9qUmV4/nwt-ballwippe/README.md

# Projekt Ballwippe

Dies ist ein Schulprojekt.

## Inhaltsverzeichnis
- [Projektauftrag](docs/Konstruktionsauftrag%20Ballwippe.pdf)
- [Dokumentation](docs/Projektdokumentation.md)
- [Notizen](docs/Notes.pdf)
- [CAD-Dateien](cad-files):
  - [Endplatte](cad-files/Endplatte.FCStd)
  - [Fuß](cad-files/Fuss.FCStd)
  - [Lager](cad-files/Lager.FCStd)
  - [Gesamtmodell](cad-files/Wippe_gesamt.FCStd)
