9qUmV4/nwt-ballwippe/cad-files/Grundplatte.FCStd

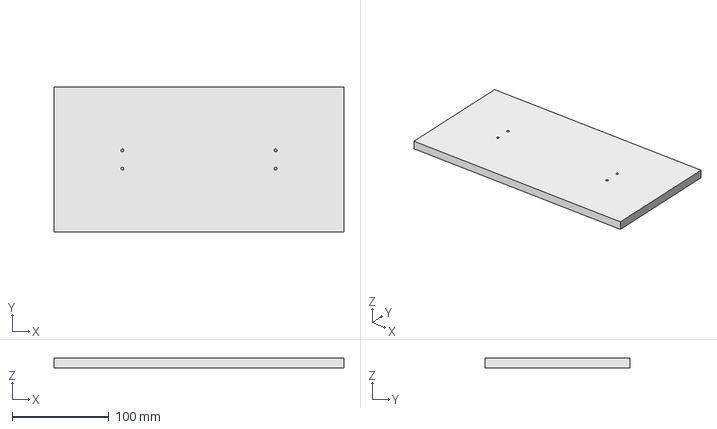
[picture p2: CAD file, 2022-02-23]
cad-files/Grundplatte.FCStd
300.0 x 150.0 x 10.0 mm
