9qUmV4/nwt-ballwippe/cad-files/stl-files/Fuss-Body.stl

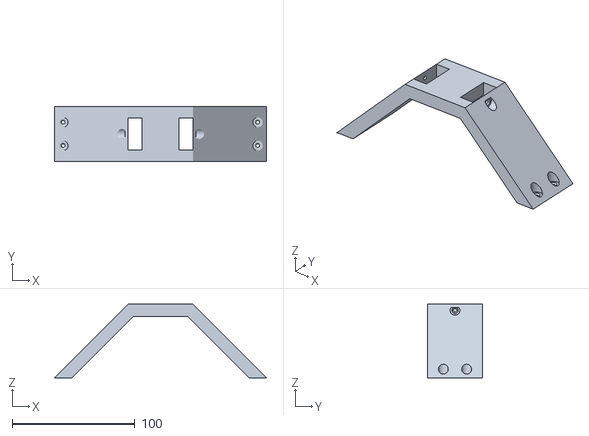
[picture p3: CAD file, 2022-04-05]
cad-files/stl-files/Fuss-Body.stl
172.8 x 45.0 x 60.0
