9qUmV4/nwt-ballwippe/cad-files/Achse.FCStd

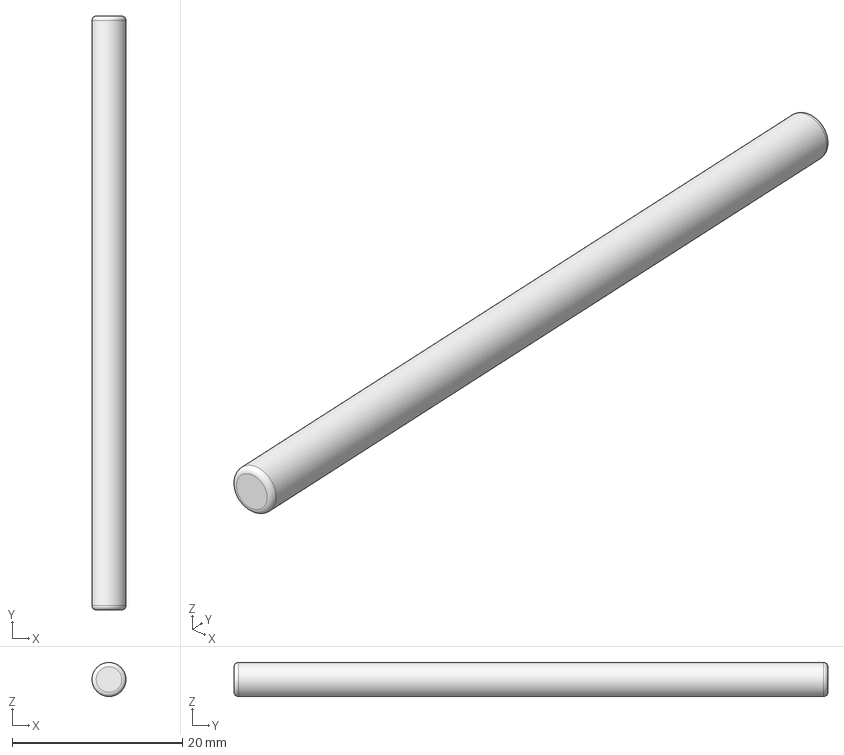
[picture p4: CAD file, 2022-02-23]
cad-files/Achse.FCStd
4.00 x 69.8 x 4.00 mm
