9qUmV4/nwt-ballwippe/cad-files/stl-files/Lager-Body.stl

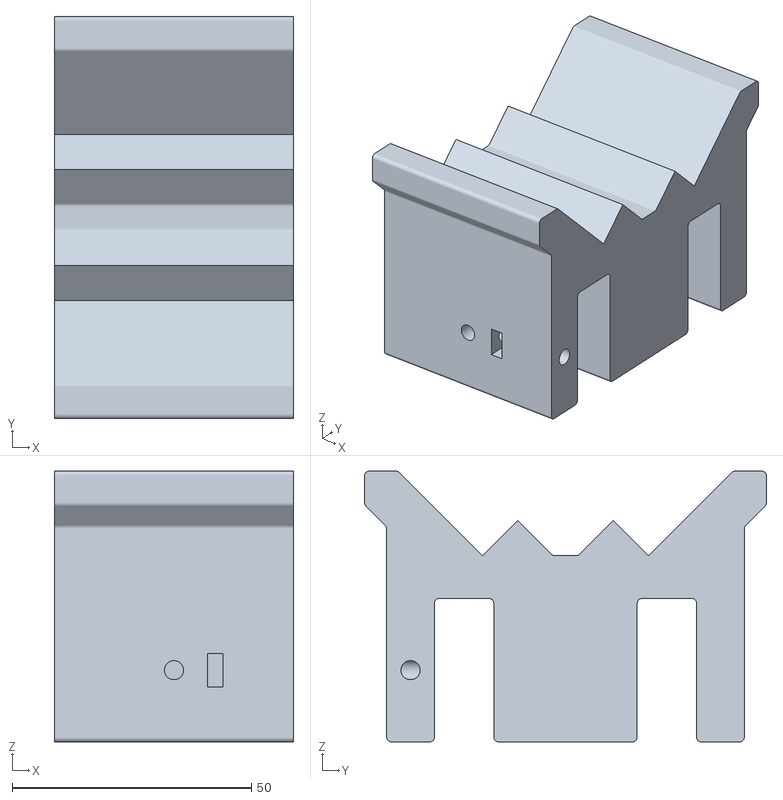
[picture p5: CAD file, 2022-04-05]
cad-files/stl-files/Lager-Body.stl
50.0 x 84.1 x 56.6
