9qUmV4/nwt-ballwippe/cad-files/stl-files/Endplatte-Body.stl

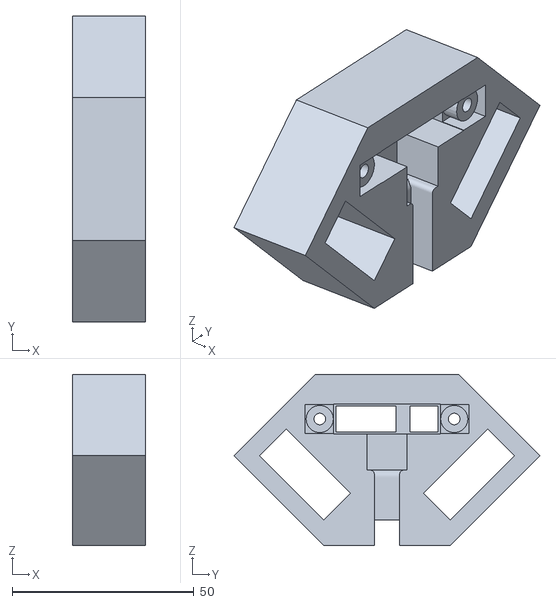
[picture p6: CAD file, 2022-04-05]
cad-files/stl-files/Endplatte-Body.stl
20.0 x 84.2 x 47.1
