9qUmV4/nwt-ballwippe/cad-files/Wippe_gesamt.FCStd

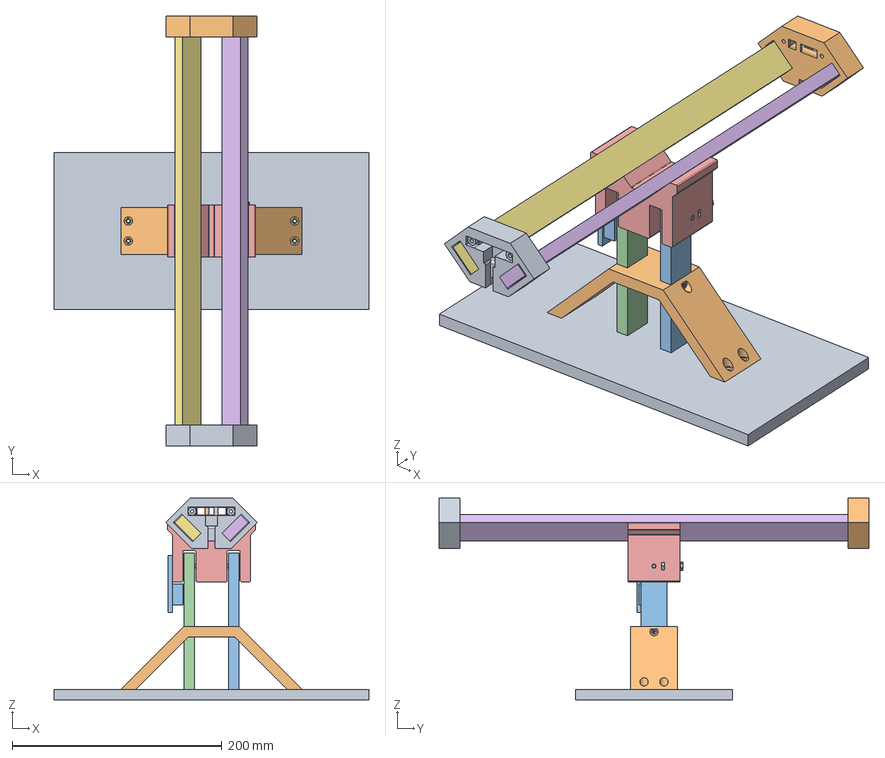
[picture p7: CAD file, 2022-02-23]
cad-files/Wippe_gesamt.FCStd
300.0 x 410.0 x 192.2 mm
Grundplatte_001
Fuss_001
Standbeine_001
Standbeine_002
Lager_001
Laufschinen_001
Laufschinen_002
Achse_001
Endplatte_001
Endplatte_002
Motorhalterung_001
M4_Mutter_001
M4_Schraube_001
M3_Schraube_10mm_001
M3_Schraube_10mm_002
