9qUmV4/nwt-ballwippe/cad-files/Standbeine.FCStd

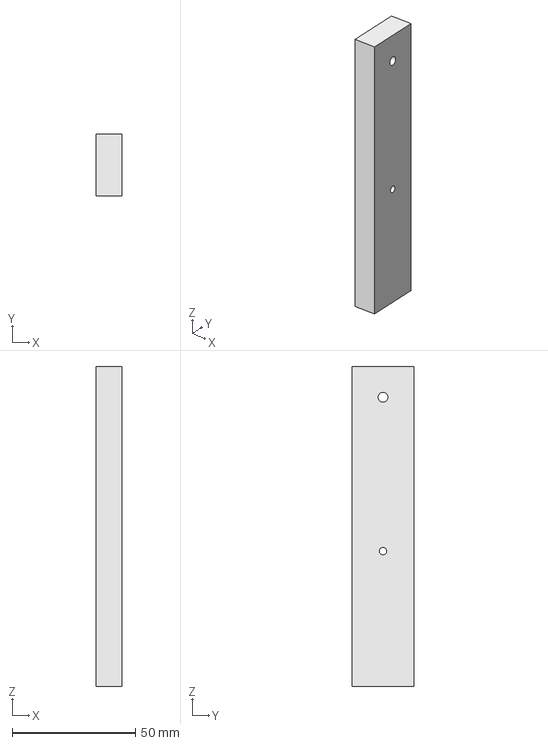
[picture p8: CAD file, 2022-02-23]
cad-files/Standbeine.FCStd
10.4 x 25.0 x 130.0 mm
