9qUmV4/nwt-ballwippe/cad-files/Laufschinen.FCStd

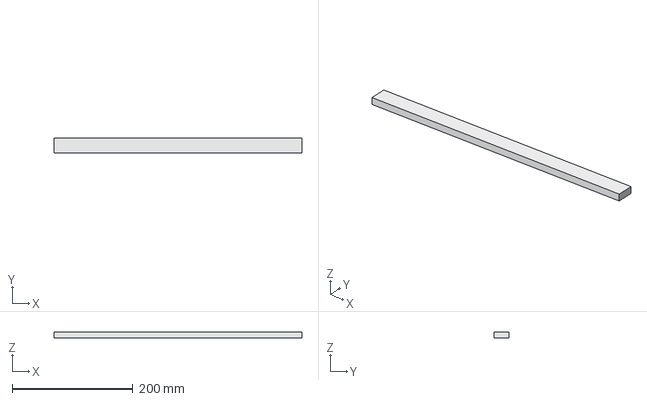
[picture p9: CAD file, 2022-02-23]
cad-files/Laufschinen.FCStd
410.0 x 25.0 x 10.4 mm
