9qUmV4/nwt-ballwippe/cad-files/M3_Schraube_10mm.FCStd

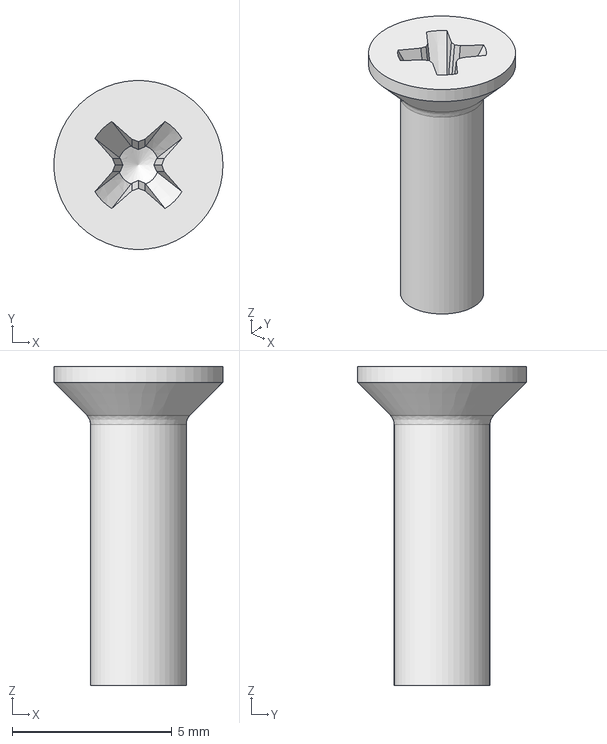
[picture p10: CAD file, 2022-02-23]
cad-files/M3_Schraube_10mm.FCStd
5.29 x 5.30 x 10.0 mm
