9qUmV4/nwt-ballwippe/cad-files/M4_Mutter.FCStd

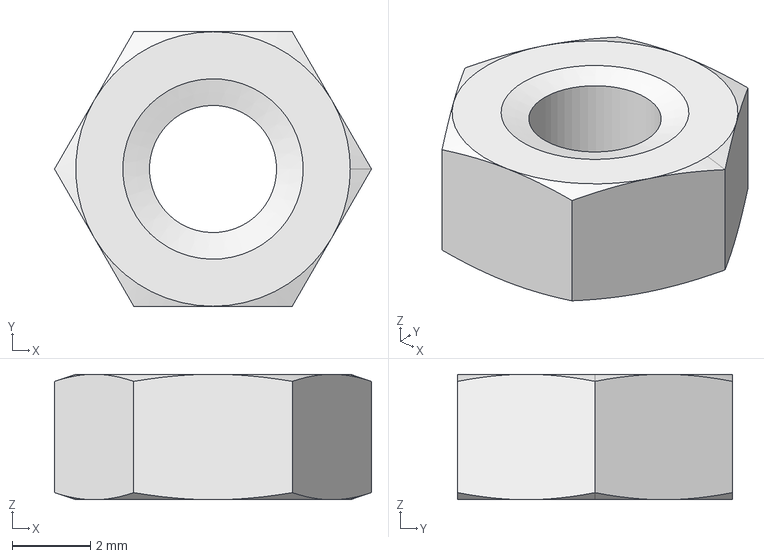
[picture p11: CAD file, 2022-02-23]
cad-files/M4_Mutter.FCStd
8.08 x 7.00 x 3.20 mm
