9qUmV4/nwt-ballwippe/cad-files/M4_Schraube.FCStd

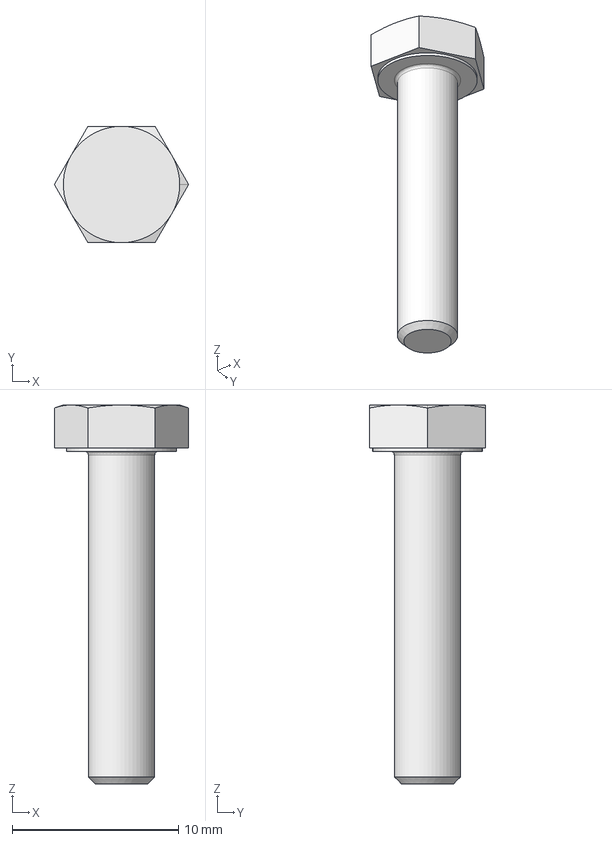
[picture p12: CAD file, 2022-02-23]
cad-files/M4_Schraube.FCStd
8.08 x 7.00 x 22.8 mm
