9qUmV4/nwt-ballwippe/cad-files/Motorhalterung.FCStd

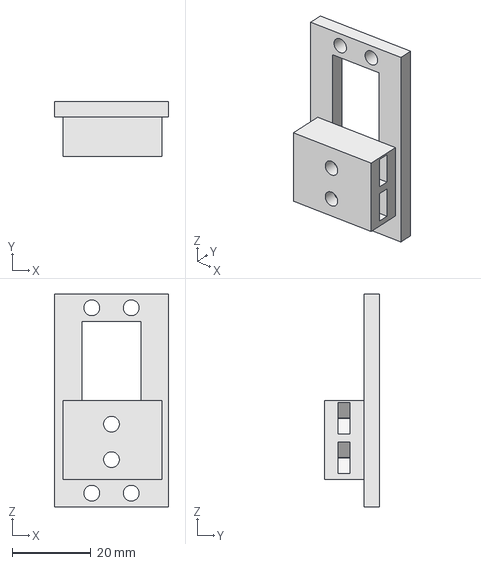
[picture p13: CAD file, 2022-02-23]
cad-files/Motorhalterung.FCStd
29.0 x 14.0 x 54.0 mm
