9qUmV4/nwt-ballwippe/cad-files/Ball_klein.FCStd

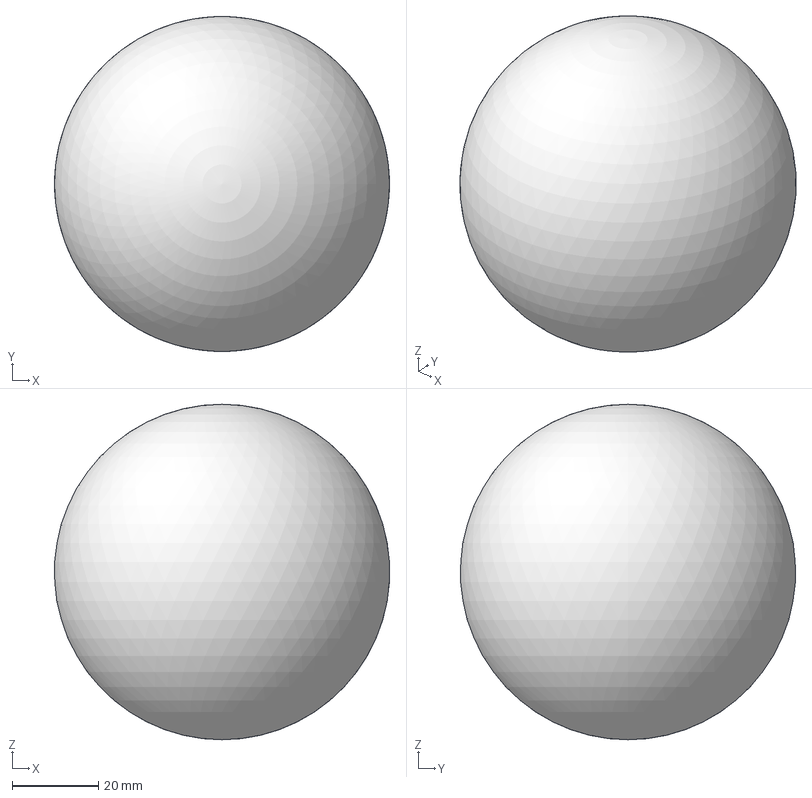
[picture p14: CAD file, 2022-01-12]
cad-files/Ball_klein.FCStd
77.9 x 77.9 x 78.0 mm
