9qUmV4/nwt-ballwippe/(list of files, cad)

Other CAD files:
cad-files/Lager.FCStd
cad-files/Endplatte.FCStd
cad-files/Fuss.FCStd
