9qUmV4/nwt-ballwippe/cad-files/Achse_drawing.pdf

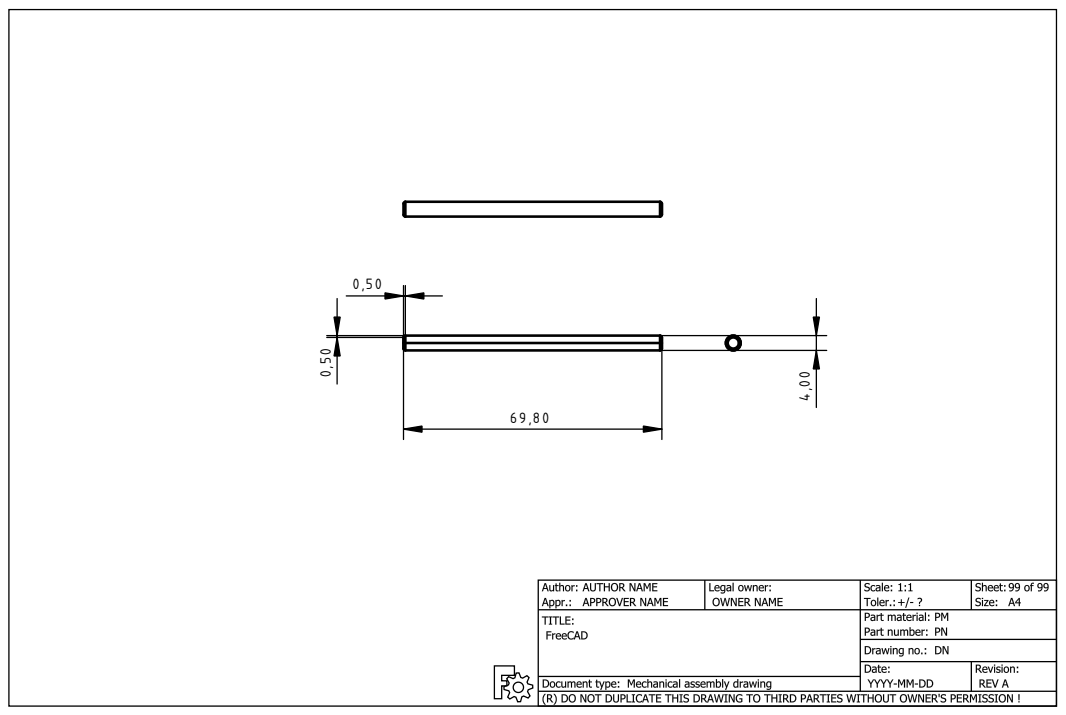
[picture p15: page 1]
