9qUmV4/nwt-ballwippe/cad-files/Grundplatte_drawing.PDF

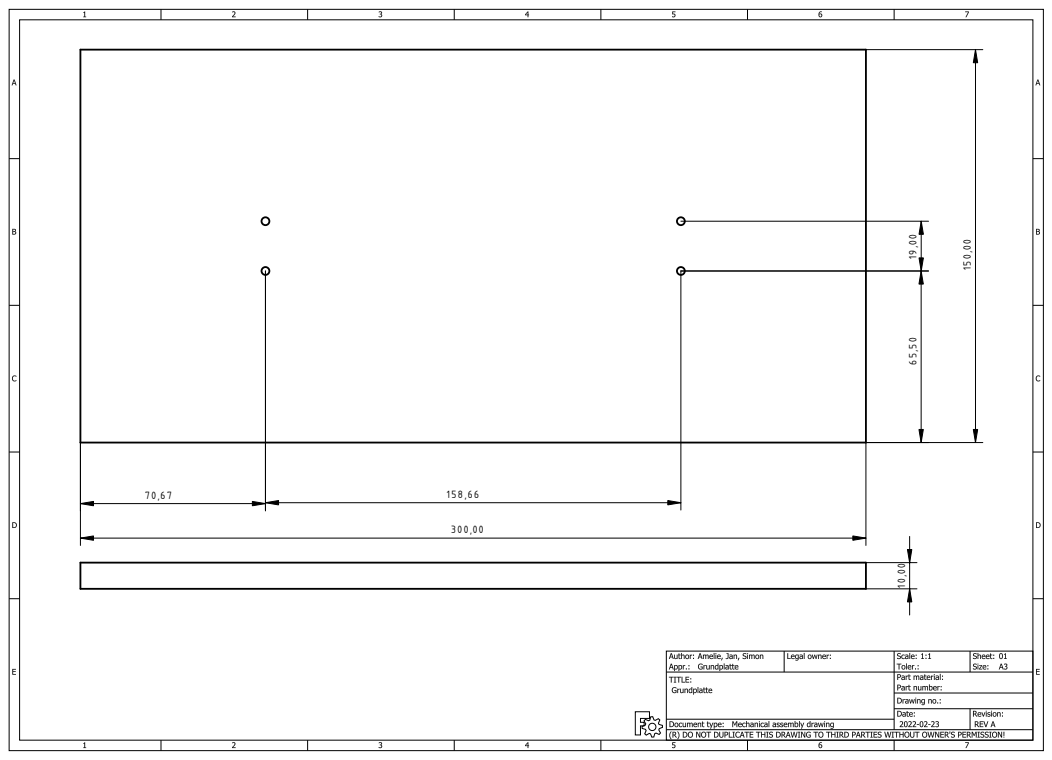
[picture p16: page 1]
