9qUmV4/nwt-ballwippe/cad-files/Lager_drawing.pdf

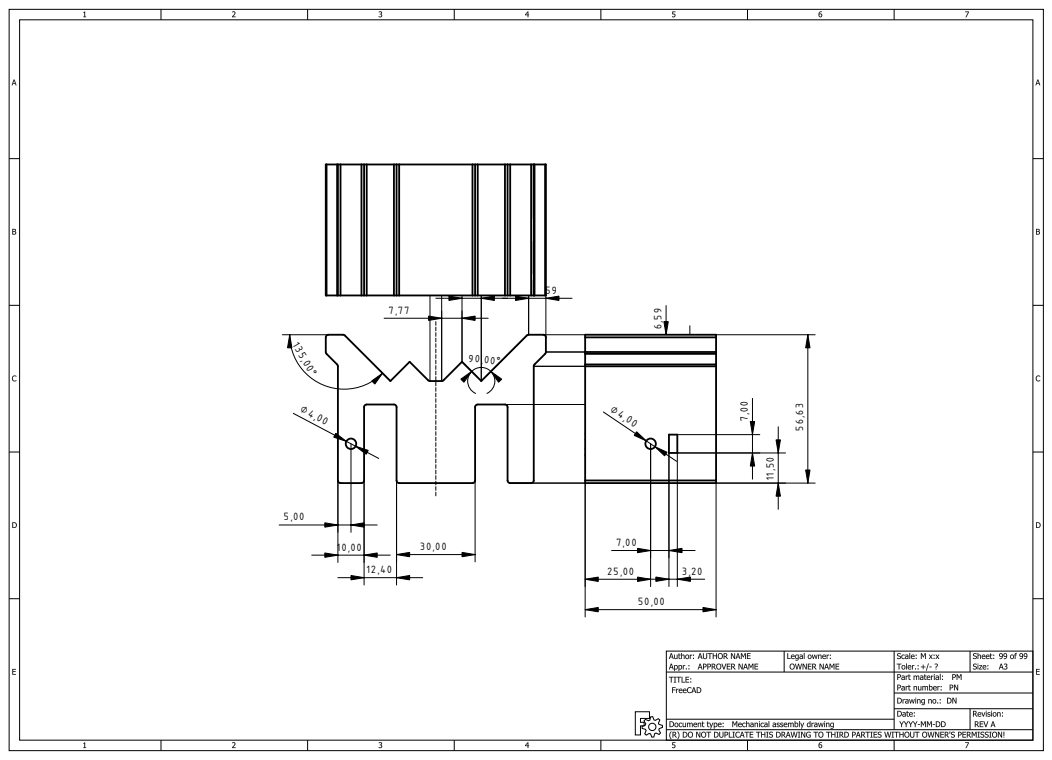
[picture p17: page 1]
