9qUmV4/nwt-ballwippe/cad-files/Laufschinen_drawing.pdf

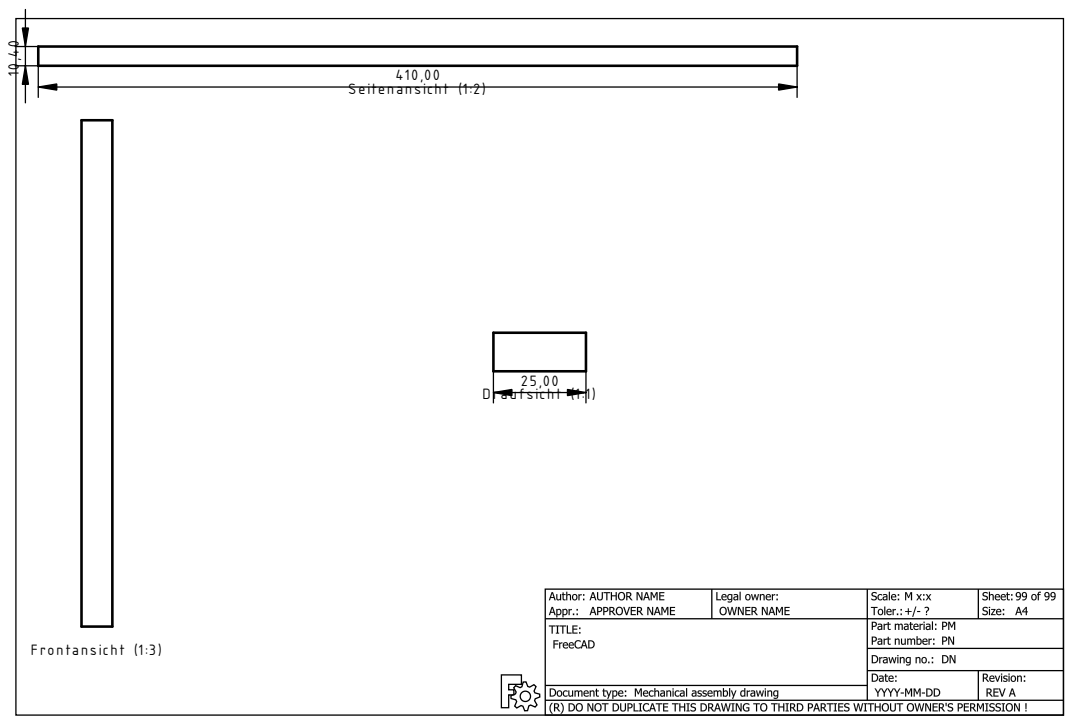
[picture p18: page 1]
S eitenansicht (1:2); D raufsicht (1:1); Frontansicht (1:3)
