9qUmV4/nwt-ballwippe/cad-files/Standbeine_drawing.pdf

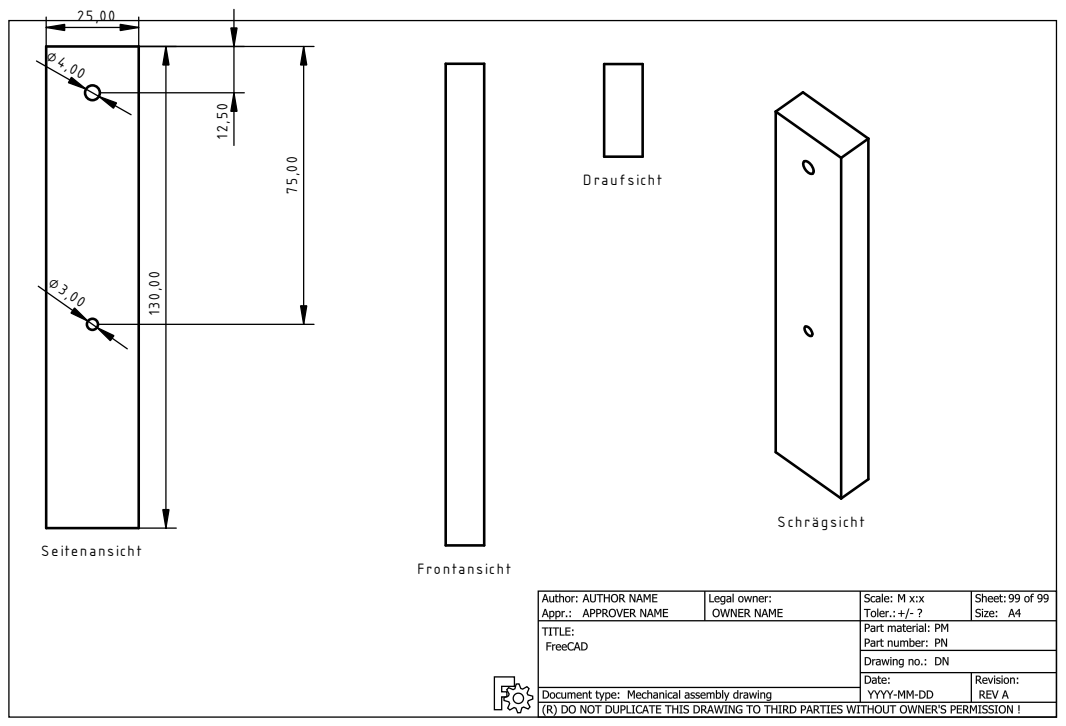
[picture p19: page 1]
S eitenansicht; Frontansicht; D raufsicht; S chrägsicht
