9qUmV4/nwt-ballwippe/cad-files/Endplatte_drawing.pdf

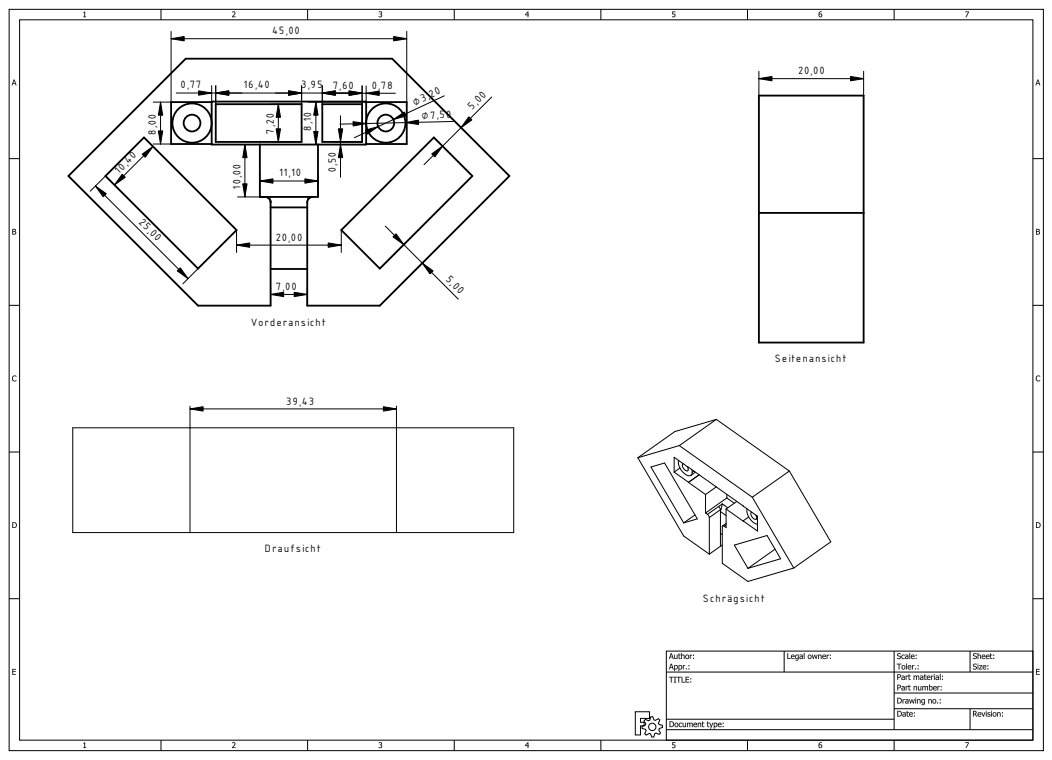
[picture p20: page 1]
Vorderansicht; S eitenansicht; D raufsicht; S chrägsicht
