9qUmV4/nwt-ballwippe/cad-files/Fuss_drawing.pdf

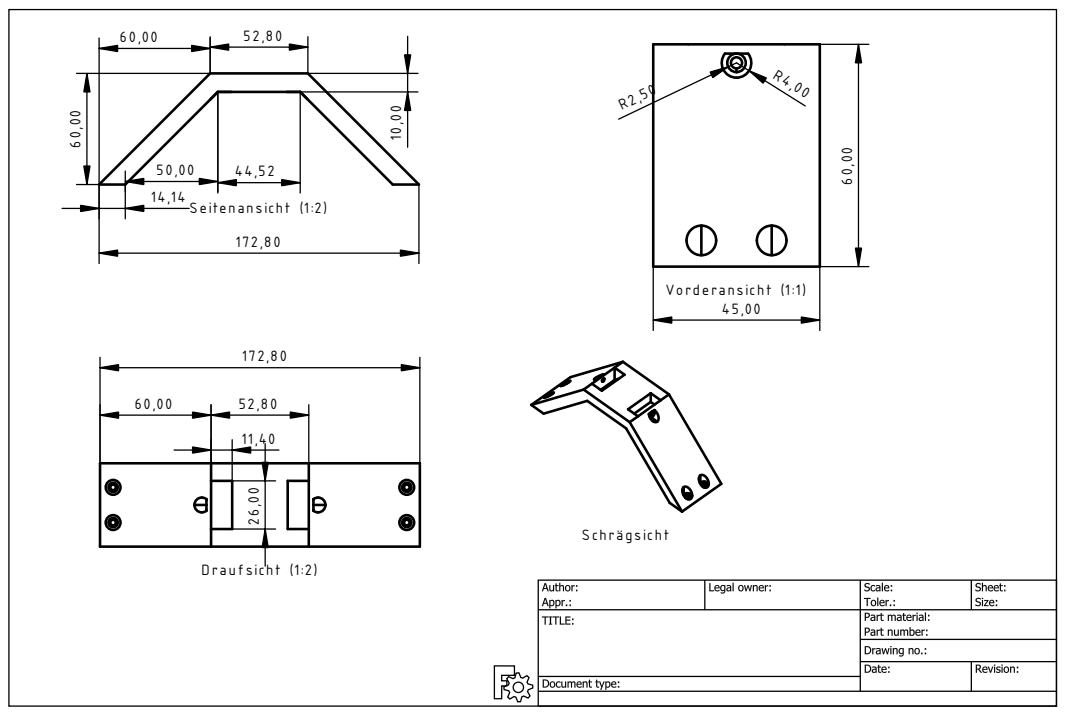
[picture p21: page 1]
S eitenansicht (1:2) 50,00; Vorderansicht (1:1); 60,00 45,00 R 4,00 R 2,50 D raufsicht (1:2) 172,80 60,00; S chrägsicht
