9qUmV4/nwt-ballwippe/(commit log)

2022-01-11 Collected sensor tests
2022-01-12 4 lesson: Start of CAD
    [Ball_klein.FCStd, Endplatte.FCStd, Fuss.FCStd, Grundplatte.FCStd, Lager.FCStd, Laufschinen.FCStd, Standbeine.FCStd, Wippe_gesamt.FCStd]
2022-01-18 more assembly
    [Fuss.FCStd, Grundplatte.FCStd, Standbeine.FCStd, Wippe_gesamt.FCStd]
2022-02-01 work on Endplatte and Lager
    [Endplatte.FCStd, Lager.FCStd]
2022-02-03 Refactoring of Lager and adding Lager to Wippe_gesamt
    [Lager.FCStd, Standbeine.FCStd, Wippe_gesamt.FCStd]
2022-02-05 First version of Endplatte finished
    [Endplatte.FCStd]
2022-02-13 Fixed asymmetry in Endplatte.FCStd
    [Endplatte.FCStd]
2022-02-18 Working on Lager
    [Lager.FCStd]
2022-02-18 Testing servos
2022-02-18 More servo testing
2022-02-23 Work of lesson 8
    [Lager.FCStd]
2022-02-23 Added Explanation to servo requirement calculations
2022-02-23 Desigend Motorhalterung
    [Motorhalterung.FCStd]
2022-02-23 Removed tolerance in Endplatte.FCStd cad drawing
    [Endplatte.FCStd]
2022-02-23 *Really* removed tolerance
    [Endplatte.FCStd]
2022-02-23 Added drawing for Endplatte and Fuss
    [Endplatte.FCStd, Fuss.FCStd]
2022-02-23 Added everything in Wippe_gesamt. Some changes in Projektdokumentation. Added Schrauben and Muttern
    [Achse.FCStd, Grundplatte.FCStd, Lager.FCStd, Laufschinen.FCStd, M3_Schraube_10mm.FCStd, M4_Mutter.FCStd, M4_Schraube.FCStd, Motorhalterung.FCStd]
2022-02-23 Added other drawings
    [Endplatte.FCStd, Laufschinen.FCStd, Standbeine.FCStd]
2022-02-23 Drawing of Lager Lager and Grundplatte
    [Lager.FCStd]
2022-02-23 Added drawing for Achse
    [Achse.FCStd, Grundplatte.FCStd, Lager.FCStd, Wippe_gesamt.FCStd]
2022-02-23 Clearify missing drawing of Motorhalterung in Dokumentation
2022-04-05 exported stl files
    [Endplatte-Body.stl, Fuss-Body.stl, Lager-Body.stl]
